strickyak/copico-bonobo/v3.0/capy-3g/RP2350-PICO2-XXL-pinout.jpg

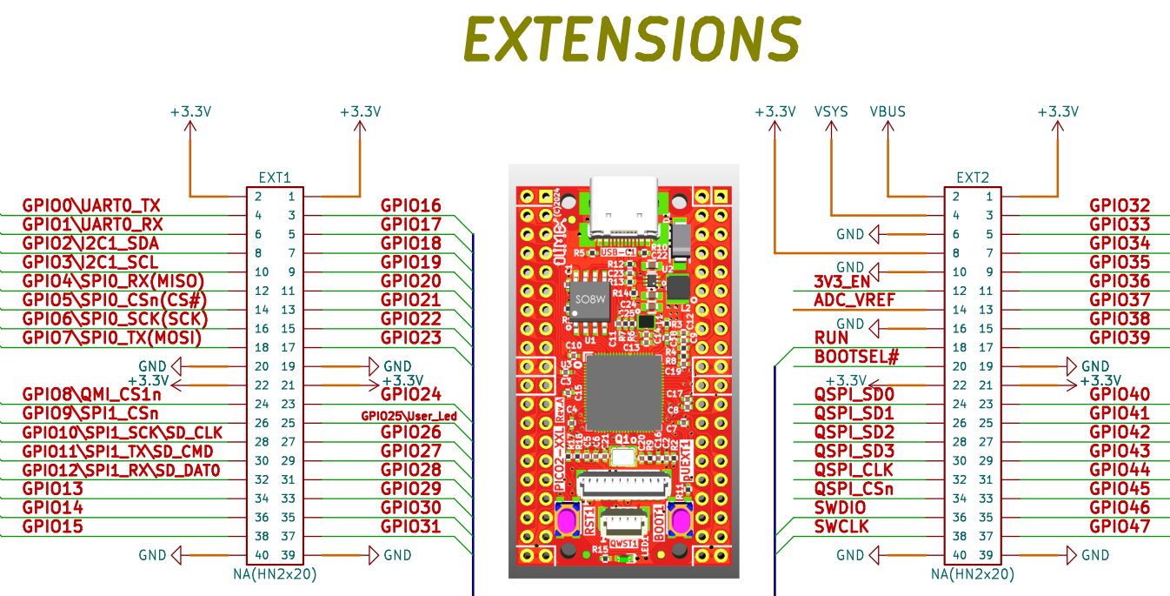
v3.0/capy-3g/RP2350-PICO2-XXL-pinout.jpg
