strickyak/copico-bonobo/README.md

# copico-bonobo
KICAD: Simple and cheap PI PICO cartridge for Coco; can spoonfeed to boot, and has Control &amp; Data ports decoded.
