strickyak/copico-bonobo/v3.1-centipede/centipede-32d/pcb-all.png

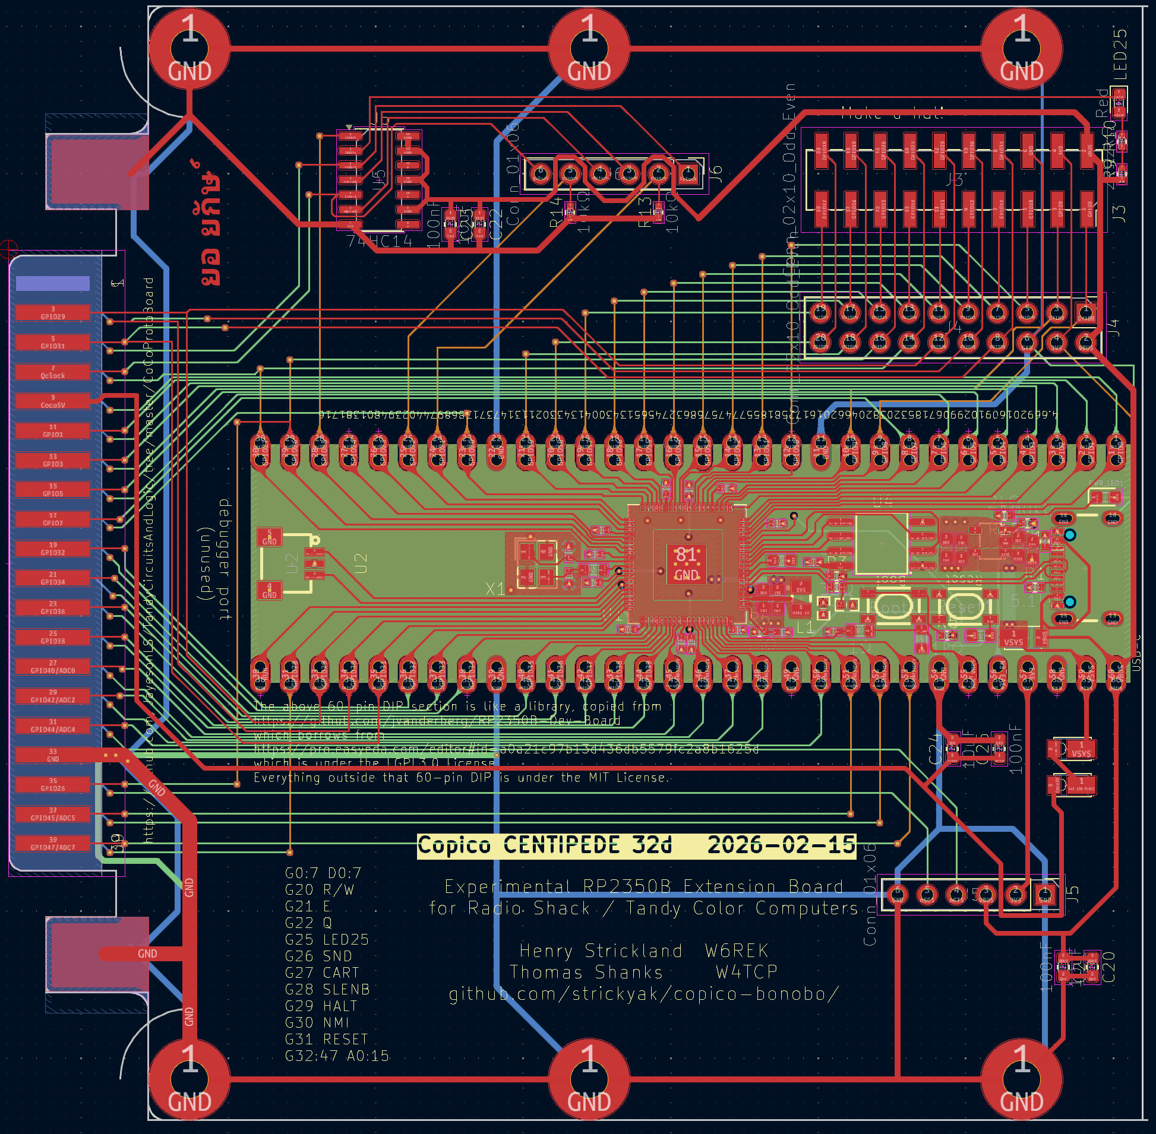
v3.1-centipede/centipede-32d/pcb-all.png
