strickyak/copico-bonobo/v3.1-centipede/centipede-32d/pcb-j3-j4.png

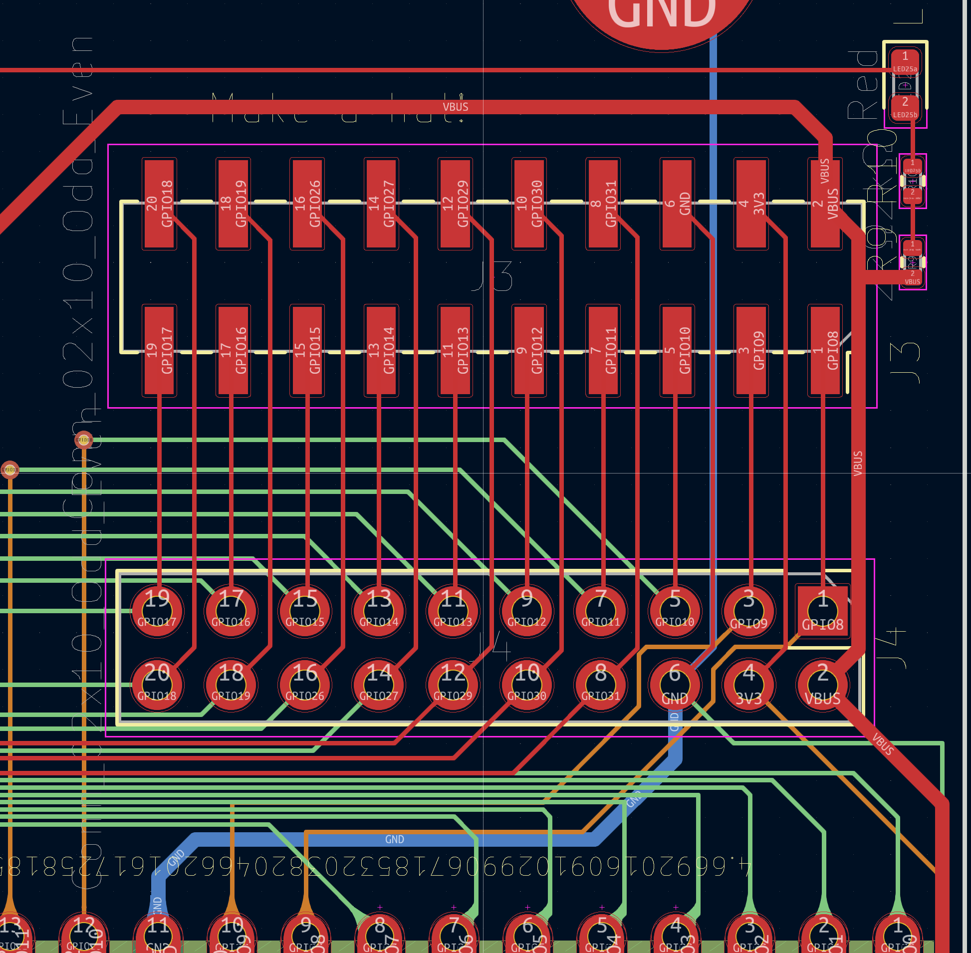
v3.1-centipede/centipede-32d/pcb-j3-j4.png
