strickyak/copico-bonobo/v3.1-centipede/centipede-32d/pcb-j6.png

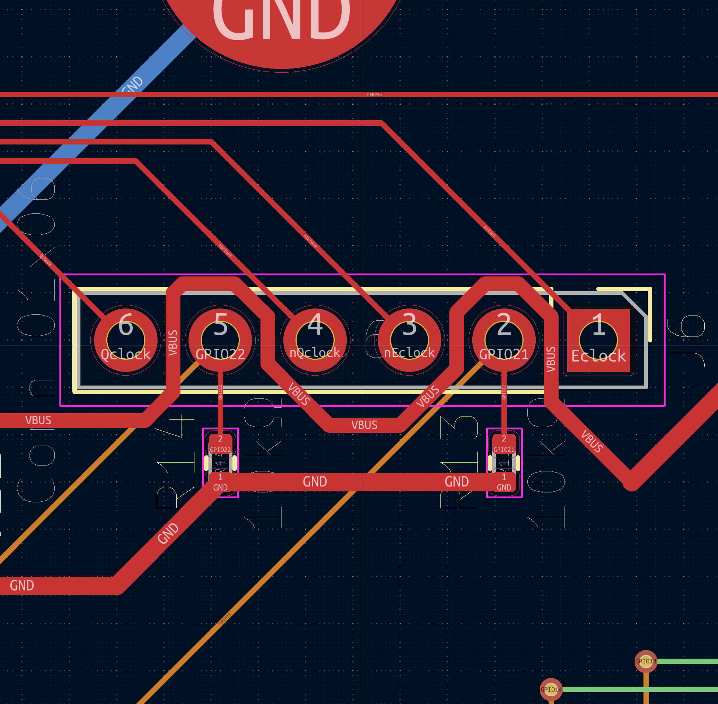
v3.1-centipede/centipede-32d/pcb-j6.png
