strickyak/copico-bonobo/v3.1-centipede/centipede-32d/pcb-rp2350b.png

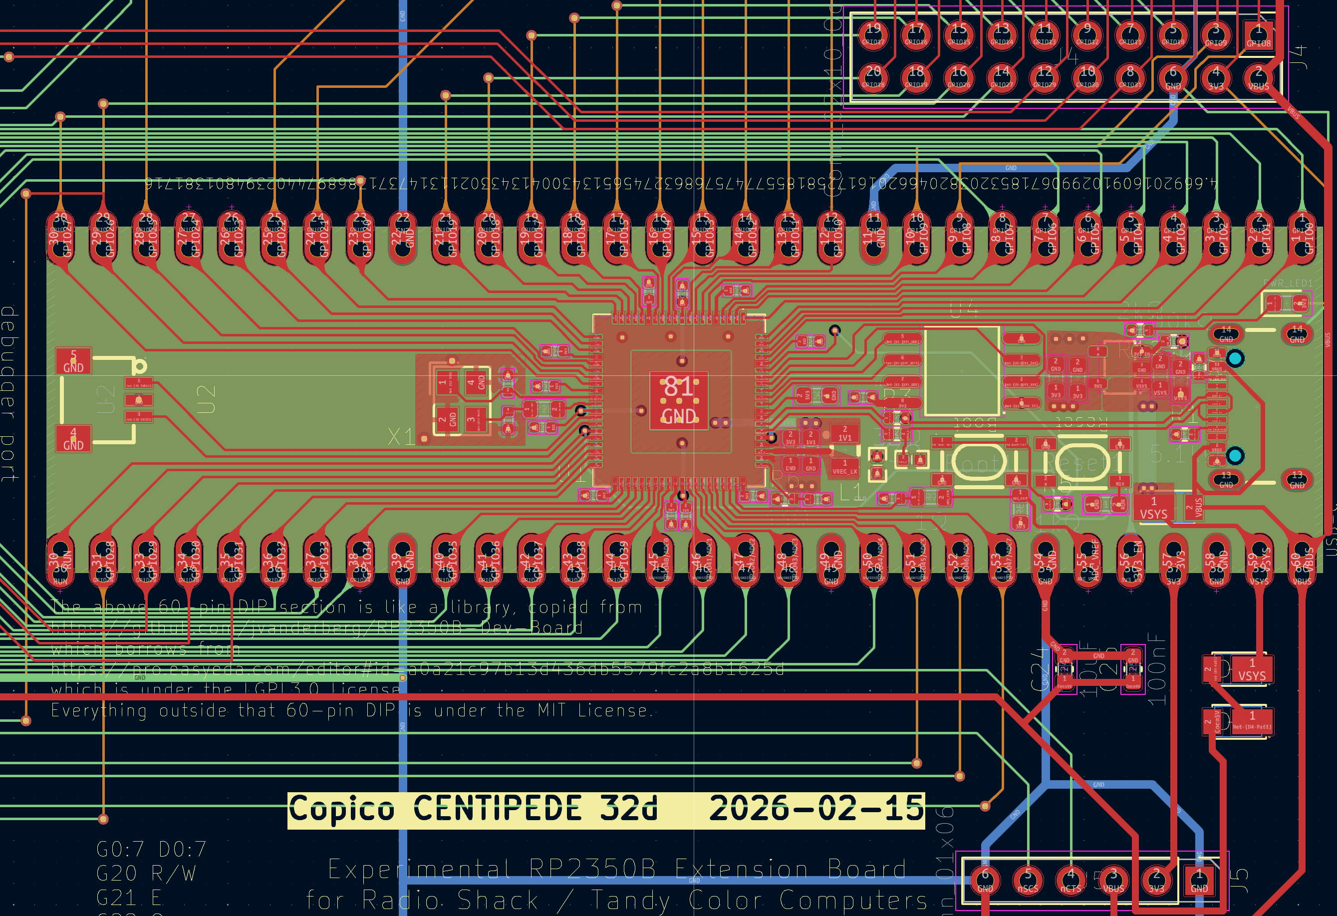
v3.1-centipede/centipede-32d/pcb-rp2350b.png
