strickyak/copico-bonobo/v3.1-centipede/centipede-32d/schematic-additions.png

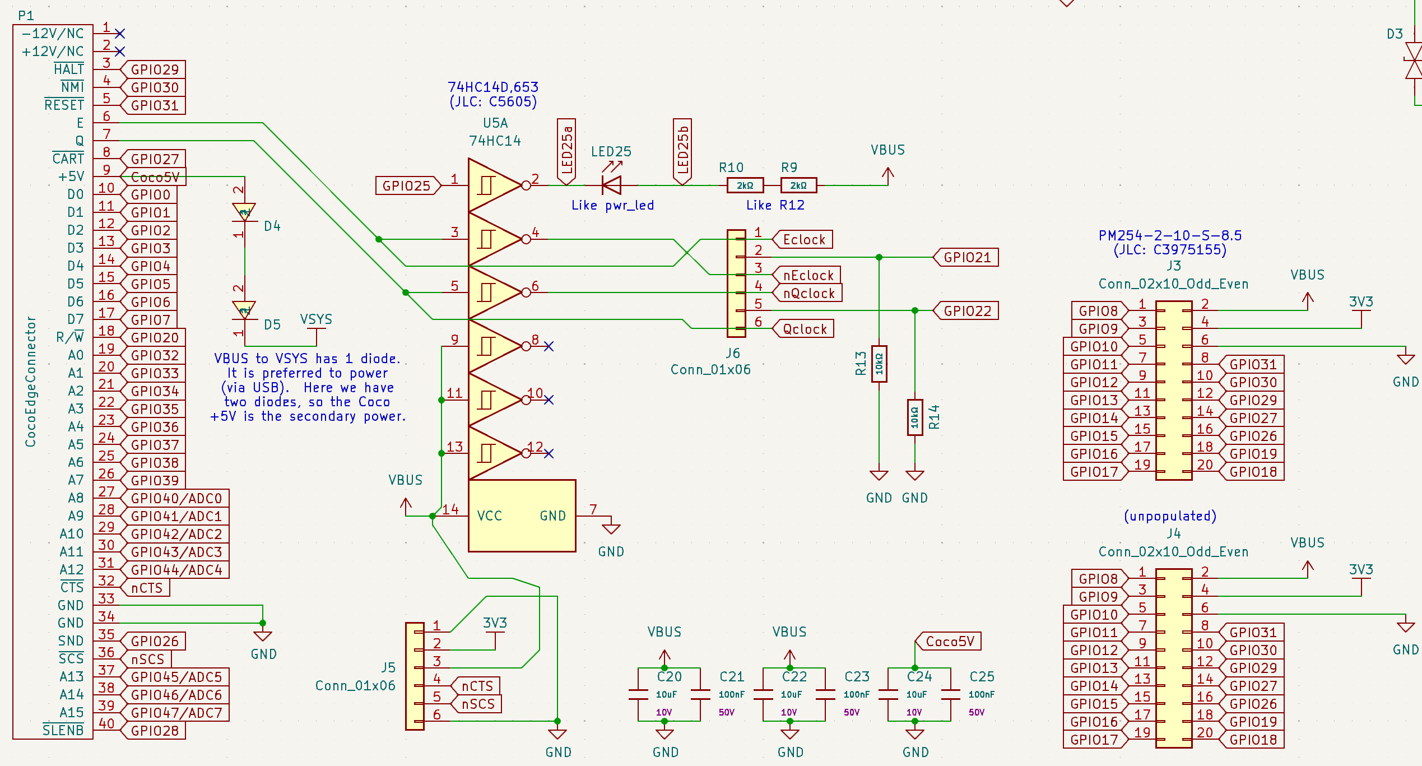
v3.1-centipede/centipede-32d/schematic-additions.png
