strickyak/copico-bonobo/v3.1-centipede/centipede-32d/schematic.png

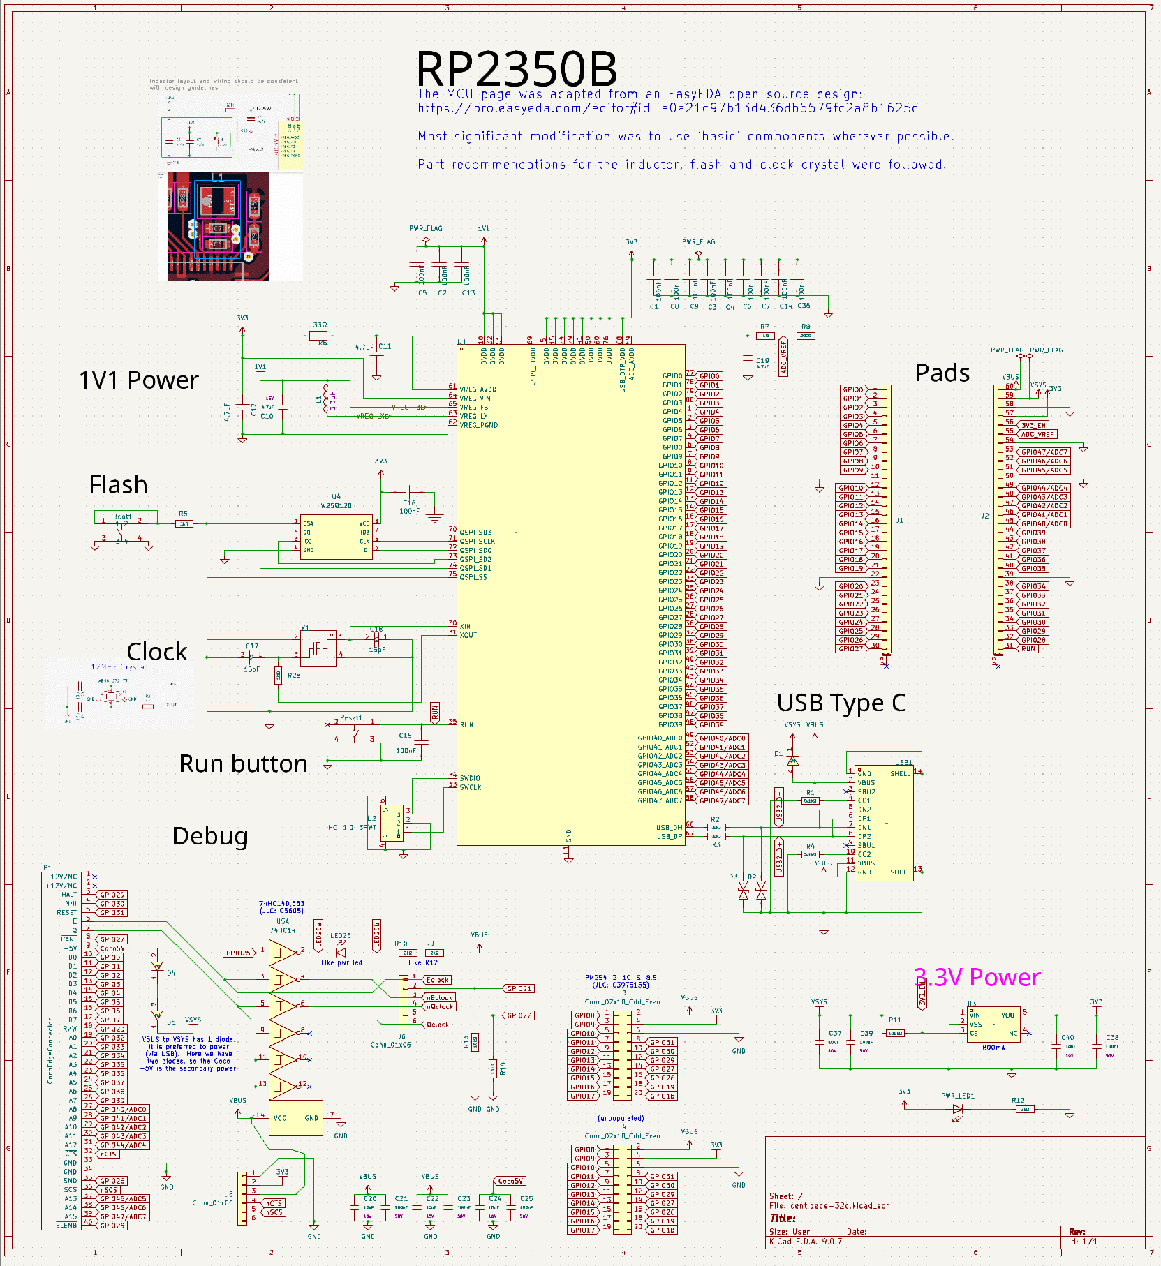
v3.1-centipede/centipede-32d/schematic.png
