strickyak/copico-bonobo/v2.4/spoon24b/bonobo_ricku_topH.stl

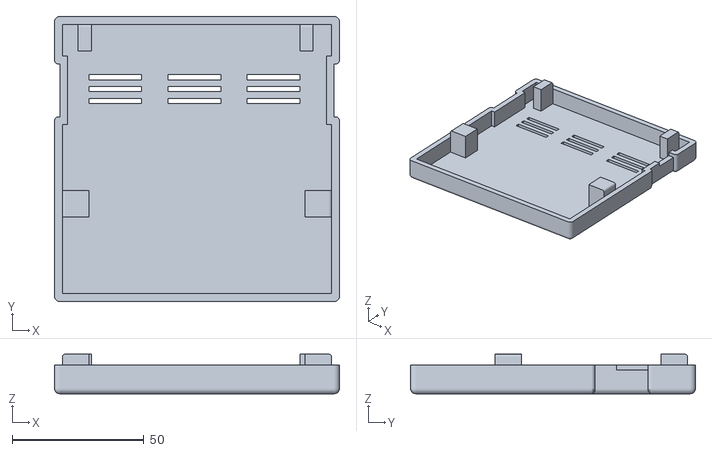
[picture p10: CAD file, 2025-08-13, an earlier design]
v2.4/spoon24b/bonobo_ricku_topH.stl
108.0 x 108.0 x 15.0
