strickyak/copico-bonobo/v3.1-centipede/centipede-32z/centipede-32z.kicad_pcb

## KiCad design v3.1-centipede/centipede-32z/centipede-32z.kicad_pcb (2026-04-16)

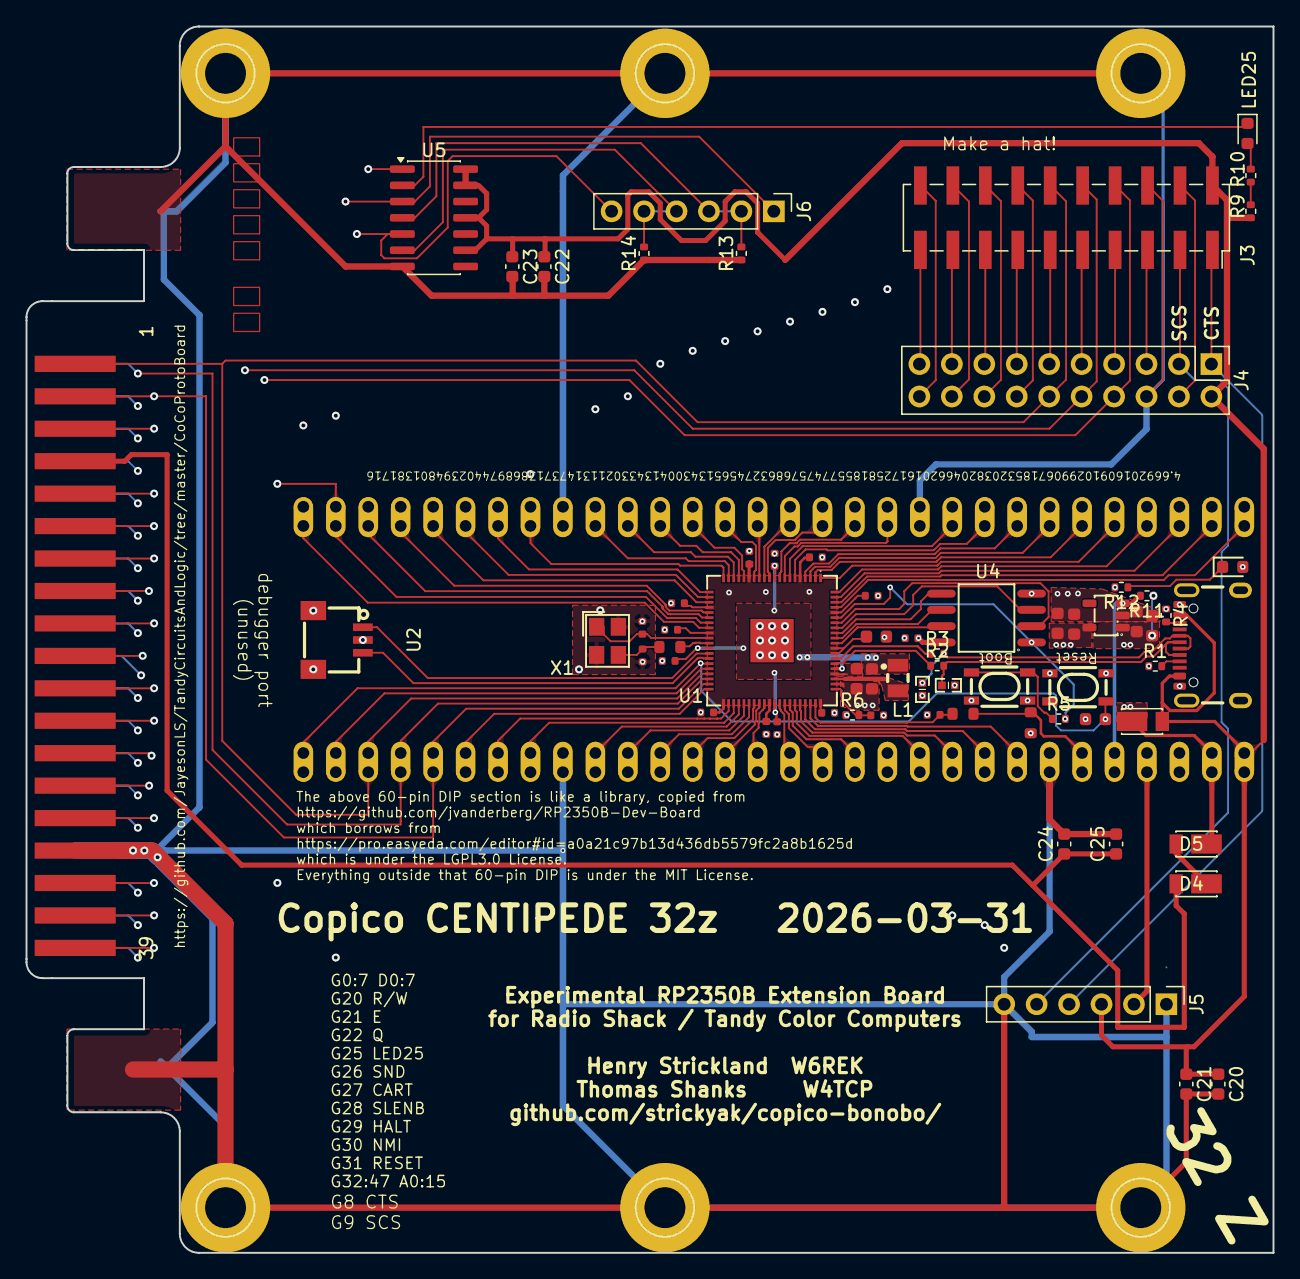
[picture p11: board centipede-32z.kicad_pcb from above]

Board: 4 copper layers, 97.6 x 96.0 mm, 127 parts (0 on the bottom side), 85 nets.

Parts:
3V3_EN1, 3V31: Castellated Pad
ADC_VREF1: Castellated Pad
Boot1: K2-1808SN-A4SW-01; KEY-SMD_4P-L4.2-W3.2-P2.20-LS5.1-TL
C1, C2, C3, C4, C5, C6, C7, C8, C13, C14, C16, C36: 100nF; C_0402
C9, C15, C38, C39: 100nF; C_0603
C10, C12: 4.7uF; C_0603
C11, C19: 4.7uF; C_0402
C17, C18: 15pF; C_0402
C20, C22, C24: 10uF; C_0603_1608Metric
C21, C23, C25: 100nF; C_0603_1608Metric
C37, C40: 10uF; C_0603
D1, D4, D5: POWERDI-123_L2.8-W1.8-LS3.7-RD
D2, D3: RCLAMP0521P.TCT-MS; D0402-BI
GND1, GND2, GND3, GND4, GND4#2, GND6: Castellated Pad
GPI10: Castellated Pad
GPIO0, GPIO1, GPIO1#2, GPIO1#3, GPIO1#4, GPIO1#5, GPIO1#6, GPIO1#7, GPIO1#8, GPIO2, GPIO3, GPIO4, GPIO5, GPIO7, GPIO8, GPIO11, GPIO12, GPIO13, GPIO15, GPIO16, GPIO17, GPIO18, GPIO19, GPIO21, GPIO21#2, GPIO22, GPIO24, GPIO25, GPIO26, GPIO27, GPIO28, GPIO29, GPIO30, GPIO32, GPIO34, GPIO35, GPIO36, GPIO37, GPIO38, GPIO39, GPIO40, GPIO41, GPIO42, GPIO43, GPIO44, GPIO45, GPIO46: Castellated Pad
J3: Conn_02x10_Odd_Even; PinSocket_2x10_P2.54mm_Vertical_SMD
J4: Conn_02x10_Odd_Even; PinHeader_2x10_P2.54mm_Vertical
J5, J6: Conn_01x06; PinHeader_1x06_P2.54mm_Vertical
L1: IND-SMD_L2.0-W1.6_AOTA-B201610S3R3-101-T
LED25: Red; LED_0603_1608Metric
P1: CocoEdgeConnector; CocoCardEdgeCocoMIDI
PWR_LED1: Red; D_0603
R1, R4: 5.1kΩ; R_0402_1005Metric
R2, R3, R6: 33Ω; R_0402_1005Metric
R5: 1kΩ; R_0402_1005Metric
R7: 1Ω; R_0603
R8: 200Ω; R_0603
R9, R10, R12: 2kΩ; R_0402_1005Metric
R11: 100kΩ; R_0402_1005Metric
R13, R14: 10kΩ; R_0402_1005Metric
R28: 1kΩ; R_0603
RUN1: Castellated Pad
Reset1: K2-1808SN-A4SW-01; KEY-SMD_4P-L4.2-W3.2-P2.20-LS5.1-TL
U1: QFN-80_L10.0-W10.0-P0.40-TL-EP3.4
U2: HC-1.0-3PWT; CONN-SMD_SM03B-SRSS-TB-LF-SN-P
U3: SOT-23-5_L3.0-W1.7-P0.95-LS2.8-BR
U4: W25Q128; SOIC-8_L5.3-W5.3-P1.27-LS8.0-BL
U5: 74HC14; SOIC-14_3.9x8.7mm_P1.27mm
USB1: USB-C-SMD_TYPE-C-6PIN-2MD-073
VBUS1: Castellated Pad
VSYS1: Castellated Pad
X1: CRYSTAL-SMD_4P-L3.2-W2.5-BL

Connections:
1V1: C2.1, C5.1, C10.2, C13.2, L1.2, U1.10 (DVDD), U1.32 (DVDD), U1.51 (DVDD), U1.65 (VREG_FB)
3V3: 3V31.57, C1.1, C3.1, C4.1, C6.1, C7.1, C8.2, C9.2, C12.2, C14.2, C16.2, C36.2, C38.1, C40.1, J3.4, J4.4, J5.2, PWR_LED1.2, R6.1, R8.2, U1.5 (IOVDD), U1.15 (IOVDD), U1.24 (IOVDD), U1.29 (IOVDD), U1.41 (IOVDD), U1.50 (IOVDD), U1.60 (IOVDD), U1.64 (VREG_VIN), U1.68 (USB_OTP_VDD), U1.69 (QSPI_IOVDD), U1.76 (IOVDD), U3.5 (VOUT), U4.8 (VCC)
3V3_EN: 3V3_EN1.56, R11.2, U3.3 (CE)
/VREG_LX: L1.1, U1.63 (VREG_LX)
ADC_VREF: ADC_VREF1.55, R7.2, R8.1
Coco5V: C24.1, C25.1, D4.2, P1.9 (+5V)
Eclock: J6.1, P1.6 (E), U5.3
GND: Boot1.3, Boot1.4, C1.2, C2.2, C3.2, C4.2, C5.2, C6.2, C7.2, C8.1, C9.1, C10.1, C11.1, C12.1, C13.1, C14.1, C15.1, C16.1, C17.2, C18.1, C19.2, C20.2, C21.2, C22.2, C23.2, C24.2, C25.2, C36.1, C37.2, C38.2, C39.2, C40.2, D2.1, D3.1, GND2.22, GND3.39, GND4.49, GND4#2.54, GND6.58, GPI10.11, J3.6, J4.6, J5.1, J5.6, P1.33 (GND), P1.34 (GND), R1.1, R4.1, R12.2, R13.1, R14.1, Reset1.3, Reset1.4, U1.62 (VREG_PGND), U1.81 (GND), U2.2, U2.4, U2.5, U3.2 (VSS), U4.4 (GND), U5.7 (GND), USB1.1 (GND), USB1.12 (GND), USB1.13 (SHELL), USB1.14 (SHELL), X1.2 (GND), X1.4 (GND)
GPIO0: GPIO0.1, P1.10 (D0), U1.77 (GPIO0)
GPIO1: GPIO1#2.2, P1.11 (D1), U1.78 (GPIO1)
GPIO2: GPIO2.3, P1.12 (D2), U1.79 (GPIO2)
GPIO3: GPIO3.4, P1.13 (D3), U1.80 (GPIO3)
GPIO4: GPIO4.5, P1.14 (D4), U1.1 (GPIO4)
GPIO5: GPIO5.6, P1.15 (D5), U1.2 (GPIO5)
GPIO6: GPIO1#8.7, P1.16 (D6), U1.3 (GPIO6)
GPIO7: GPIO7.8, P1.17 (D7), U1.4 (GPIO7)
GPIO8: GPIO8.9, J3.1, J4.1, J5.4, P1.32 (~CTS), U1.6 (GPIO8)
GPIO9: GPIO1#7.10, J3.3, J4.3, J5.5, P1.36 (~SCS), U1.7 (GPIO9)
GPIO10: GND1.12, J3.5, J4.5, U1.8 (GPIO10)
GPIO11: GPIO11.13, J3.7, J4.7, U1.9 (GPIO11)
GPIO12: GPIO12.14, J3.9, J4.9, U1.11 (GPIO12)
GPIO13: GPIO13.15, J3.11, J4.11, U1.12 (GPIO13)
GPIO14: GPIO1#6.16, J3.13, J4.13, U1.13 (GPIO14)
GPIO15: GPIO15.17, J3.15, J4.15, U1.14 (GPIO15)
GPIO16: GPIO16.18, J3.17, J4.17, U1.16 (GPIO16)
GPIO17: GPIO17.19, J3.19, J4.19, U1.17 (GPIO17)
GPIO18: GPIO18.20, J3.20, J4.20, U1.18 (GPIO18)
GPIO19: GPIO19.21, J3.18, J4.18, U1.19 (GPIO19)
GPIO20: GPIO21.23, P1.18 (R/~W), U1.20 (GPIO20)
GPIO21: GPIO21#2.24, J6.2, J6.3, R13.2, U1.21 (GPIO21), U5.4
GPIO22: GPIO22.25, J6.4, J6.5, R14.2, U1.22 (GPIO22), U5.6
GPIO23: GPIO1#5.26, U1.23 (GPIO23)
GPIO24: GPIO24.27, U1.25 (GPIO24)
GPIO25: GPIO25.28, U1.26 (GPIO25), U5.1
GPIO26: GPIO26.29, J3.16, J4.16, P1.35 (SND), U1.27 (GPIO26)
GPIO27: GPIO27.30, J3.14, J4.14, P1.8 (~CART), U1.28 (GPIO27)
GPIO28: GPIO28.31, P1.40 (~SLENB), U1.36 (GPIO28)
GPIO29: GPIO29.33, J3.12, J4.12, P1.3 (~HALT), U1.37 (GPIO29)
GPIO30: GPIO30.34, J3.10, J4.10, P1.4 (~NMI), U1.38 (GPIO30)
GPIO31: GPIO1#4.1, GPIO1#4.35, J3.8, J4.8, P1.5 (~RESET), U1.39 (GPIO31)
GPIO32: GPIO1.36, P1.19 (A0), U1.40 (GPIO32)
GPIO33: GPIO32.37, P1.20 (A1), U1.42 (GPIO33)
GPIO34: GPIO34.38, P1.21 (A2), U1.43 (GPIO34)
GPIO35: GPIO35.40, P1.22 (A3), U1.44 (GPIO35)
GPIO36: GPIO36.41, P1.23 (A4), U1.45 (GPIO36)
GPIO37: GPIO37.42, P1.24 (A5), U1.46 (GPIO37)
GPIO38: GPIO38.43, P1.25 (A6), U1.47 (GPIO38)
GPIO39: GPIO39.44, P1.26 (A7), U1.48 (GPIO39)
GPIO40/ADC0: GPIO40.45, P1.27 (A8), U1.49 (GPIO40_ADC0)
GPIO41/ADC1: GPIO41.46, P1.28 (A9), U1.52 (GPIO41_ADC1)
GPIO42/ADC2: GPIO42.47, P1.29 (A10), U1.53 (GPIO42_ADC2)
GPIO43/ADC3: GPIO43.48, P1.30 (A11), U1.54 (GPIO43_ADC3)
GPIO44/ADC4: GPIO44.50, P1.31 (A12), U1.55 (GPIO44_ADC4)
GPIO45/ADC5: GPIO45.51, P1.37 (A13), U1.56 (GPIO45_ADC5)
GPIO46/ADC6: GPIO46.52, P1.38 (A14), U1.57 (GPIO46_ADC6)
GPIO47/ADC7: GPIO1#3.53, P1.39 (A15), U1.58 (GPIO47_ADC7)
LED25a: LED25.1, U5.2
LED25b: LED25.2, R10.1
unnamed: Boot1.1, Boot1.2, R5.1
unnamed: C17.1, R28.1, X1.3
unnamed: D4.1, D5.2
unnamed: PWR_LED1.1, R12.1
unnamed: R9.1, R10.2
unnamed: C19.1, R7.1, U1.59 (ADC_AVDD)
unnamed: U1.71 (QSPI_SCLK), U4.6 (CLK)
unnamed: U1.72 (QSPI_SD0), U4.5 (DI)
unnamed: U1.74 (QSPI_SD1), U4.2 (DO)
unnamed: U1.73 (QSPI_SD2), U4.3 (IO2)
unnamed: U1.70 (QSPI_SD3), U4.7 (IO3)
unnamed: R5.2, U1.75 (QSPI_SS), U4.1 (CS#)
unnamed: U1.33 (SWCLK), U2.1
unnamed: U1.34 (SWDIO), U2.3
unnamed: R2.1, U1.66 (USB_DM)
unnamed: R3.1, U1.67 (USB_DP)
unnamed: C11.2, R6.2, U1.61 (VREG_AVDD)
unnamed: C18.2, U1.30 (XIN), X1.1
unnamed: R28.2, U1.31 (XOUT)
unnamed: R1.2, USB1.4 (CC1)
unnamed: R4.2, USB1.10 (CC2)
Qclock: J6.6, P1.7 (Q), U5.5
RUN: C15.2, RUN1.30, Reset1.1, U1.35 (RUN)
USB2_D+: D3.2, R3.2, USB1.6 (DP1), USB1.8 (DP2)
USB2_D-: D2.2, R2.2, USB1.5 (DN2), USB1.7 (DN1)
VBUS: C20.1, C21.1, C22.1, C23.1, D1.2, J3.2, J4.2, J5.3, R9.2, U5.9, U5.11, U5.13, U5.14 (VCC), USB1.2 (VBUS), USB1.11 (VBUS), VBUS1.60
VSYS: C37.1, C39.1, D1.1, D5.1, R11.1, U3.1 (VIN), VSYS1.59
