strickyak/copico-bonobo/v3.0/capy-3g/capy-3g.kicad_pcb

## KiCad design v3.0/capy-3g/capy-3g.kicad_pcb (2025-05-19)

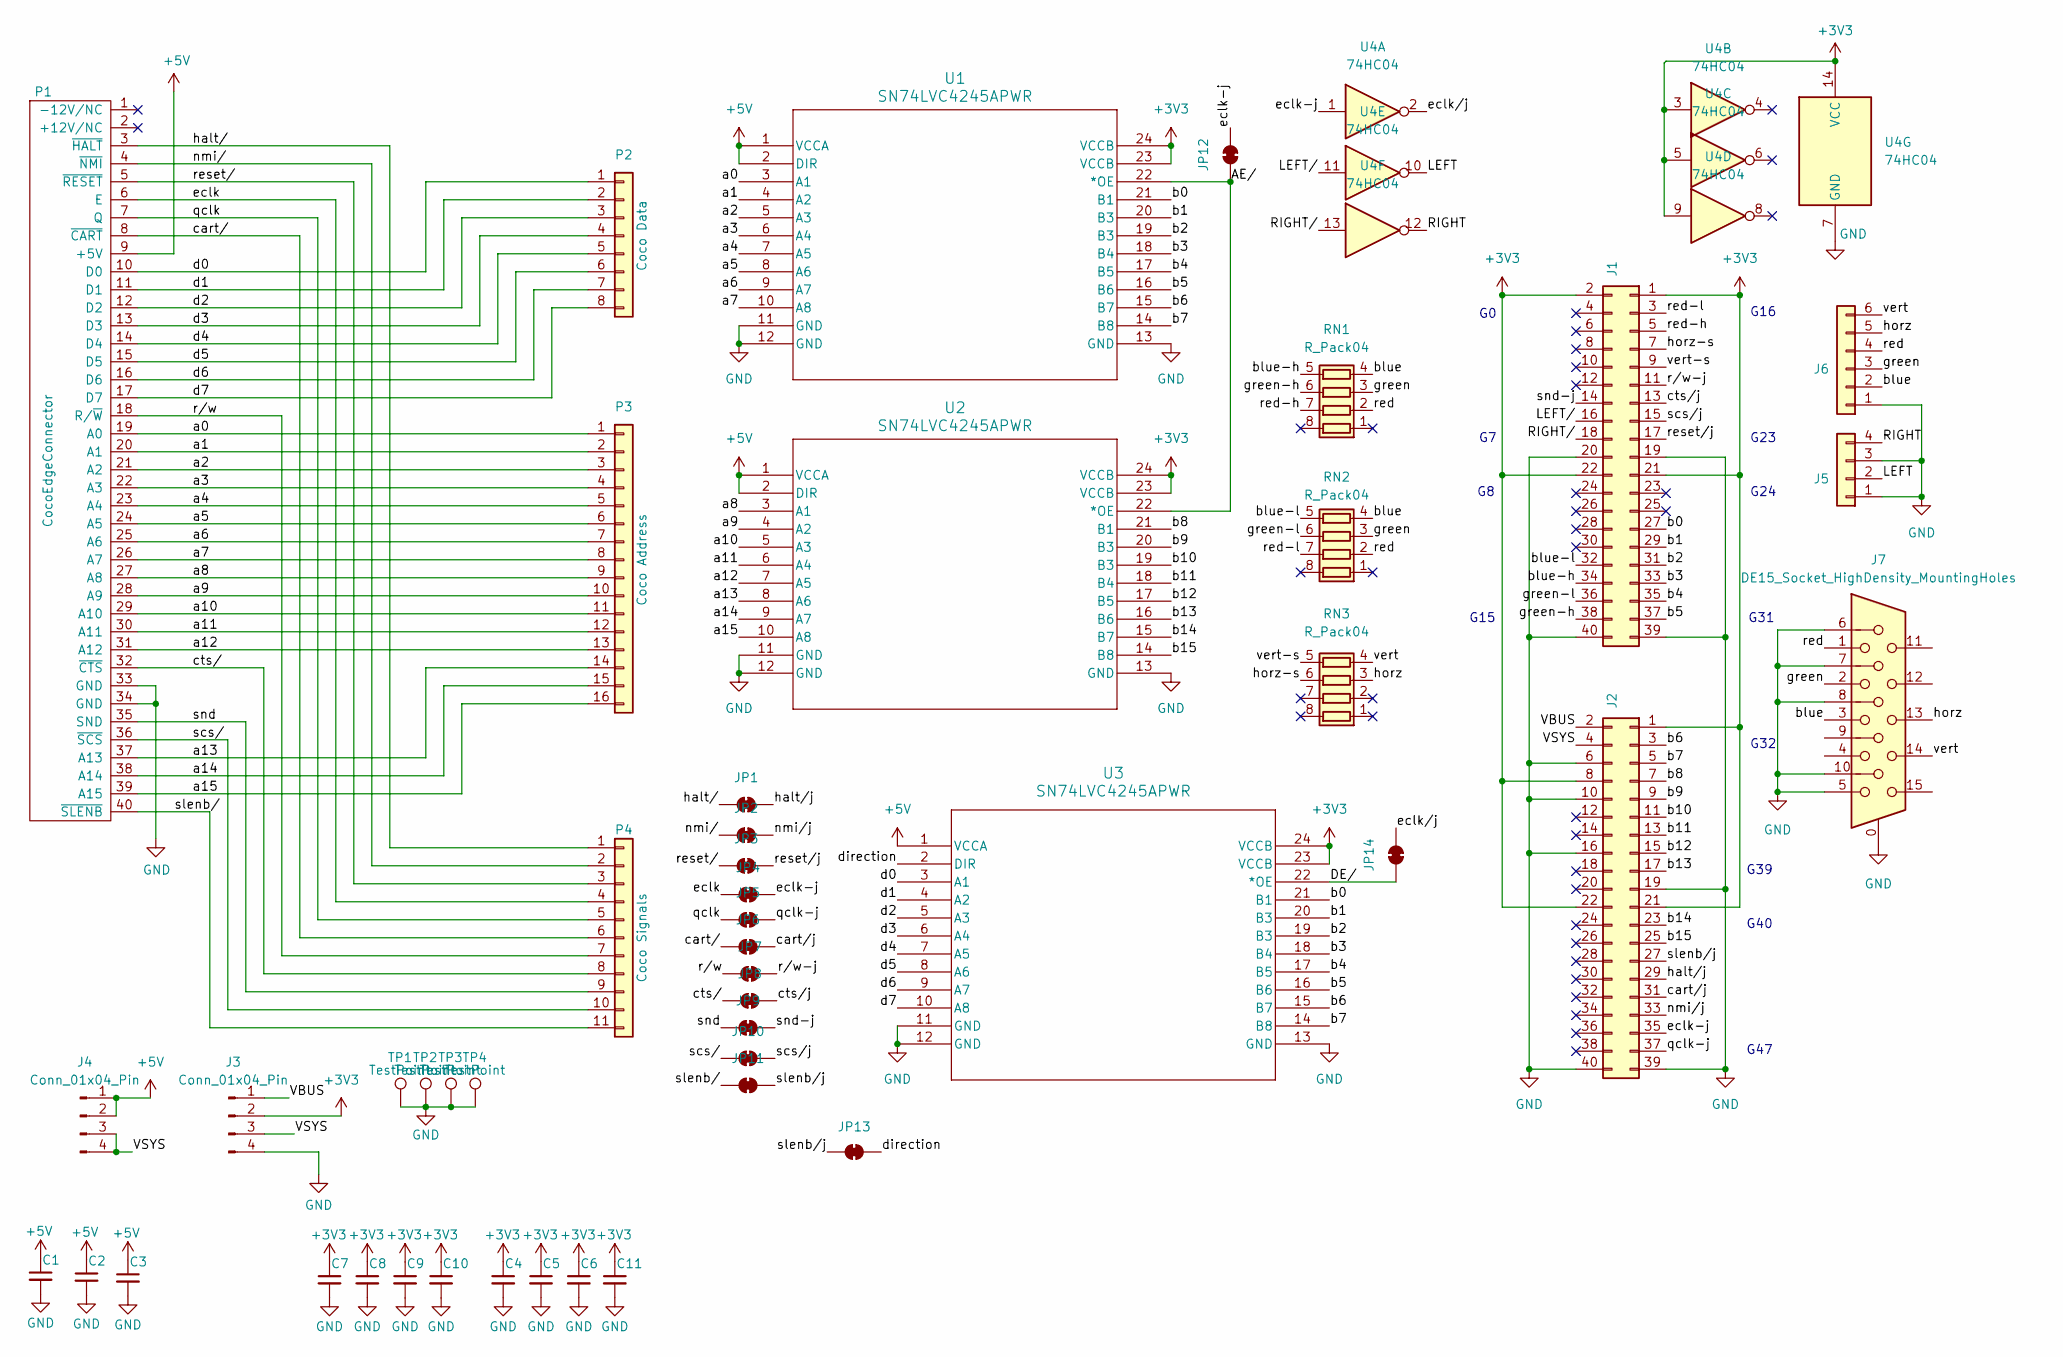
[picture p12: schematic capy-3g.kicad_sch, COPICO Bonobo]

Parts:
C1, C2, C3, C4, C5, C6, C7, C8, C9, C10, C11: C_Small; C_0402_1005Metric
J1, J2: Conn_02x20_Odd_Even; PinHeader_2x20_P2.54mm_Vertical
J3, J4: Conn_01x04_Pin; PinHeader_1x04_P2.54mm_Vertical
J5: Conn_01x04; PinHeader_1x04_P2.54mm_Vertical
J6: Conn_01x06; PinHeader_1x06_P2.54mm_Vertical
J7: DE15_Socket_HighDensity_MountingHoles; DSUB-15-HD_Socket_Vertical_P2.29x1.98mm_MountingHoles
JP1, JP2, JP3, JP4, JP5, JP6, JP7, JP8, JP9, JP10, JP11, JP12, JP13, JP14: SolderJumper_2_Bridged; SolderJumper-2_P1.3mm_Bridged_RoundedPad1.0x1.5mm
P1: CocoEdgeConnector; CocoCardEdgeCocoMIDI
P2: Coco Data; DIP-16_W7.62mm
P3: Coco Address; DIP-32_W15.24mm
P4: Coco Signals; DIP-22_W10.16mm
RN1, RN2, RN3: R_Pack04; R_Array_Convex_4x0603
TP1, TP2, TP3, TP4: TestPoint; TestPoint_Plated_Hole_D4.0mm
U1, U2, U3: SN74LVC4245APWR; TSSOP-24_4.4x7.8mm_P0.65mm
U4: 74HC04; TSSOP-14_4.4x5mm_P0.65mm

Connections:
+3V3: C4.1, C5.1, C6.1, C7.1, C8.1, C9.1, C10.1, C11.1, J1.1, J1.2, J1.21, J1.22, J2.1, J2.8, J2.21, J2.22, J3.2, U1.23 (VCCB), U1.24 (VCCB), U2.23 (VCCB), U2.24 (VCCB), U3.23 (VCCB), U3.24 (VCCB), U4.3, U4.5, U4.9, U4.14 (VCC)
+5V: C1.1, C2.1, C3.1, J4.1, J4.2, P1.9 (+5V), U1.1 (VCCA), U1.2 (DIR), U2.1 (VCCA), U2.2 (DIR), U3.1 (VCCA)
/AE/: JP12.1 (A), U1.22 (*OE), U2.22 (*OE)
/DE/: JP14.1 (A), U3.22 (*OE)
/LEFT: J5.2, U4.10
/LEFT/: J1.16, U4.11
/RIGHT: J5.4, U4.12
/RIGHT/: J1.18, U4.13
/VBUS: J2.2, J3.1
/VSYS: J2.4, J3.3, J4.3, J4.4
/a0: P1.19 (A0), P3.1, U1.3 (A1)
/a1: P1.20 (A1), P3.2, U1.4 (A2)
/a2: P1.21 (A2), P3.3, U1.5 (A3)
/a3: P1.22 (A3), P3.4, U1.6 (A4)
/a4: P1.23 (A4), P3.5, U1.7 (A5)
/a5: P1.24 (A5), P3.6, U1.8 (A6)
/a6: P1.25 (A6), P3.7, U1.9 (A7)
/a7: P1.26 (A7), P3.8, U1.10 (A8)
/a8: P1.27 (A8), P3.9, U2.3 (A1)
/a9: P1.28 (A9), P3.10, U2.4 (A2)
/a10: P1.29 (A10), P3.11, U2.5 (A3)
/a11: P1.30 (A11), P3.12, U2.6 (A4)
/a12: P1.31 (A12), P3.13, U2.7 (A5)
/a13: P1.37 (A13), P3.14, U2.8 (A6)
/a14: P1.38 (A14), P3.15, U2.9 (A7)
/a15: P1.39 (A15), P3.16, U2.10 (A8)
/b0: J1.27, U1.21 (B1), U3.21 (B1)
/b1: J1.29, U1.20 (B3), U3.20 (B3)
/b2: J1.31, U1.19 (B3), U3.19 (B3)
/b3: J1.33, U1.18 (B4), U3.18 (B4)
/b4: J1.35, U1.17 (B5), U3.17 (B5)
/b5: J1.37, U1.16 (B6), U3.16 (B6)
/b6: J2.3, U1.15 (B7), U3.15 (B7)
/b7: J2.5, U1.14 (B8), U3.14 (B8)
/b8: J2.7, U2.21 (B1)
/b9: J2.9, U2.20 (B3)
/b10: J2.11, U2.19 (B3)
/b11: J2.13, U2.18 (B4)
/b12: J2.15, U2.17 (B5)
/b13: J2.17, U2.16 (B6)
/b14: J2.23, U2.15 (B7)
/b15: J2.25, U2.14 (B8)
/blue: J6.2, J7.3, RN1.4 (R4.1), RN2.4 (R4.1)
/blue-h: J1.34, RN1.5 (R4.2)
/blue-l: J1.32, RN2.5 (R4.2)
/cart/: JP6.1 (A), P1.8 (~CART), P4.6
/cart/j: J2.31, JP6.2 (B)
/cts/: JP8.1 (A), P1.32 (~CTS), P4.8
/cts/j: J1.13, JP8.2 (B)
/d0: P1.10 (D0), P2.1, U3.3 (A1)
/d1: P1.11 (D1), P2.2, U3.4 (A2)
/d2: P1.12 (D2), P2.3, U3.5 (A3)
/d3: P1.13 (D3), P2.4, U3.6 (A4)
/d4: P1.14 (D4), P2.5, U3.7 (A5)
/d5: P1.15 (D5), P2.6, U3.8 (A6)
/d6: P1.16 (D6), P2.7, U3.9 (A7)
/d7: P1.17 (D7), P2.8, U3.10 (A8)
/direction: JP13.1 (A), U3.2 (DIR)
/eclk: JP4.1 (A), P1.6 (E), P4.4
/eclk-j: J2.35, JP4.2 (B), JP12.2 (B), U4.1
/eclk/j: JP14.2 (B), U4.2
/green: J6.3, J7.2, RN1.3 (R3.1), RN2.3 (R3.1)
/green-h: J1.38, RN1.6 (R3.2)
/green-l: J1.36, RN2.6 (R3.2)
/halt/: JP1.1 (A), P1.3 (~HALT), P4.1
/halt/j: J2.29, JP1.2 (B)
/horz: J6.5, J7.13, RN3.3 (R3.1)
/horz-s: J1.7, RN3.6 (R3.2)
/nmi/: JP2.1 (A), P1.4 (~NMI), P4.2
/nmi/j: J2.33, JP2.2 (B)
/qclk: JP5.1 (A), P1.7 (Q), P4.5
/qclk-j: J2.37, JP5.2 (B)
/red: J6.4, J7.1, RN1.2 (R2.1), RN2.2 (R2.1)
/red-h: J1.5, RN1.7 (R2.2)
/red-l: J1.3, RN2.7 (R2.2)
/reset/: JP3.1 (A), P1.5 (~RESET), P4.3
/reset/j: J1.17, JP3.2 (B)
/r/w: JP7.1 (A), P1.18 (R/~W), P4.7
/r/w-j: J1.11, JP7.2 (B)
/scs/: JP10.1 (A), P1.36 (~SCS), P4.10
/scs/j: J1.15, JP10.2 (B)
/slenb/: JP11.1 (A), P1.40 (~SLENB), P4.11
/slenb/j: J2.27, JP11.2 (B), JP13.2 (B)
/snd: JP9.1 (A), P1.35 (SND), P4.9
/snd-j: J1.14, JP9.2 (B)
/vert: J6.6, J7.14, RN3.4 (R4.1)
/vert-s: J1.9, RN3.5 (R4.2)
GND: C1.2, C2.2, C3.2, C4.2, C5.2, C6.2, C7.2, C8.2, C9.2, C10.2, C11.2, J1.19, J1.20, J1.39, J1.40, J2.6, J2.10, J2.16, J2.19, J2.39, J2.40, J3.4, J5.1, J5.3, J6.1, J7.0, J7.5, J7.6, J7.7, J7.8, J7.10, P1.33 (GND), P1.34 (GND), TP1.1, TP2.1, TP3.1, TP4.1, U1.11 (GND), U1.12 (GND), U1.13 (GND), U2.11 (GND), U2.12 (GND), U2.13 (GND), U3.11 (GND), U3.12 (GND), U3.13 (GND), U4.7 (GND)

Notes on the sheet:
G40
G23
G15
G31
G24
G32
G39
G47
G16

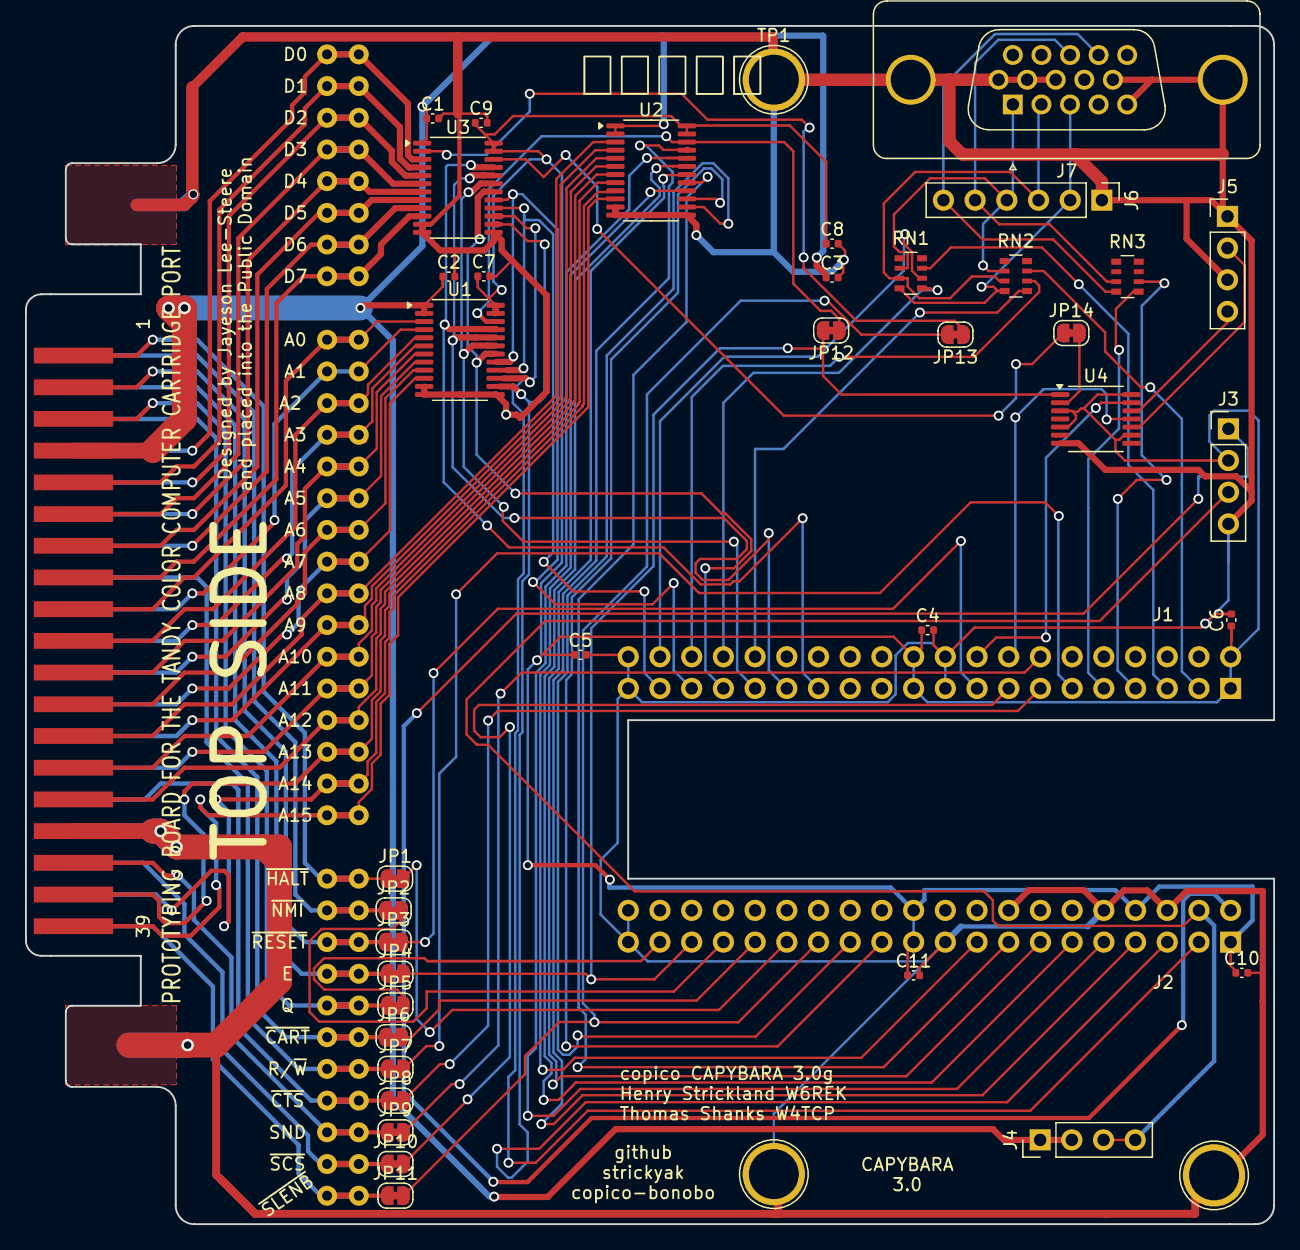
[picture p13: board capy-3g.kicad_pcb from above]

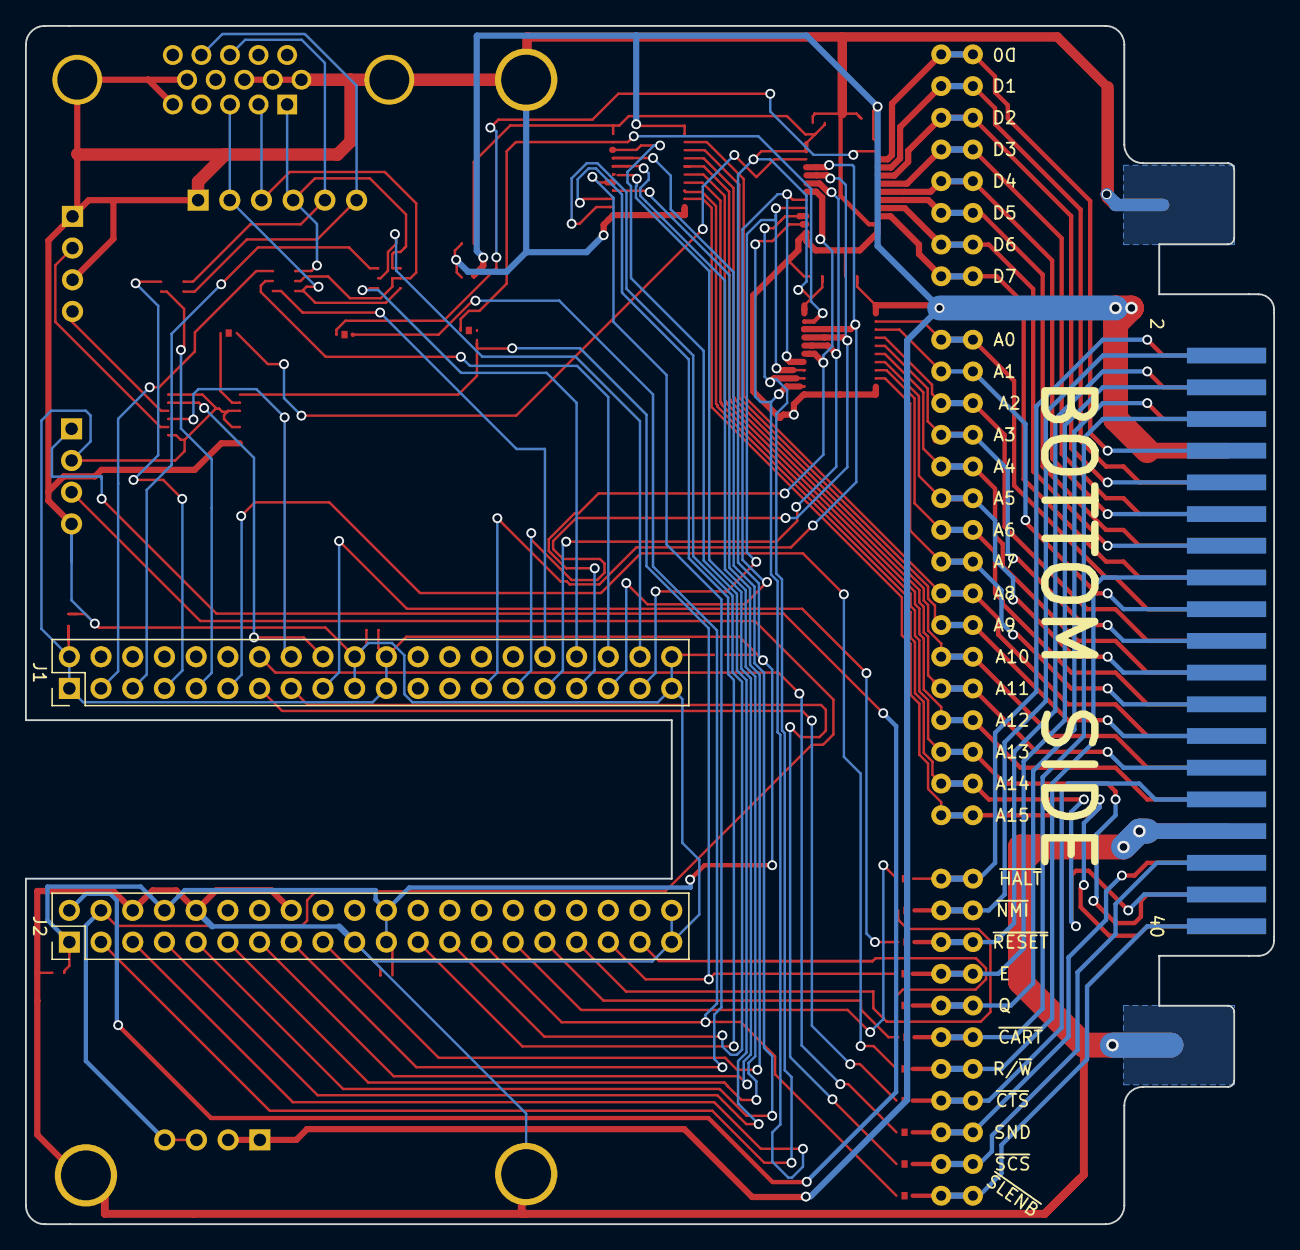
[picture p14: board capy-3g.kicad_pcb from below]

Board: 2 copper layers, 100.0 x 96.0 mm, 46 parts (2 on the bottom side), 88 nets.
