strickyak/copico-bonobo/v2.4/spoon24b/spoon24b.kicad_pcb

## KiCad design v2.4/spoon24b/spoon24b.kicad_pcb (2025-02-24, an earlier design)

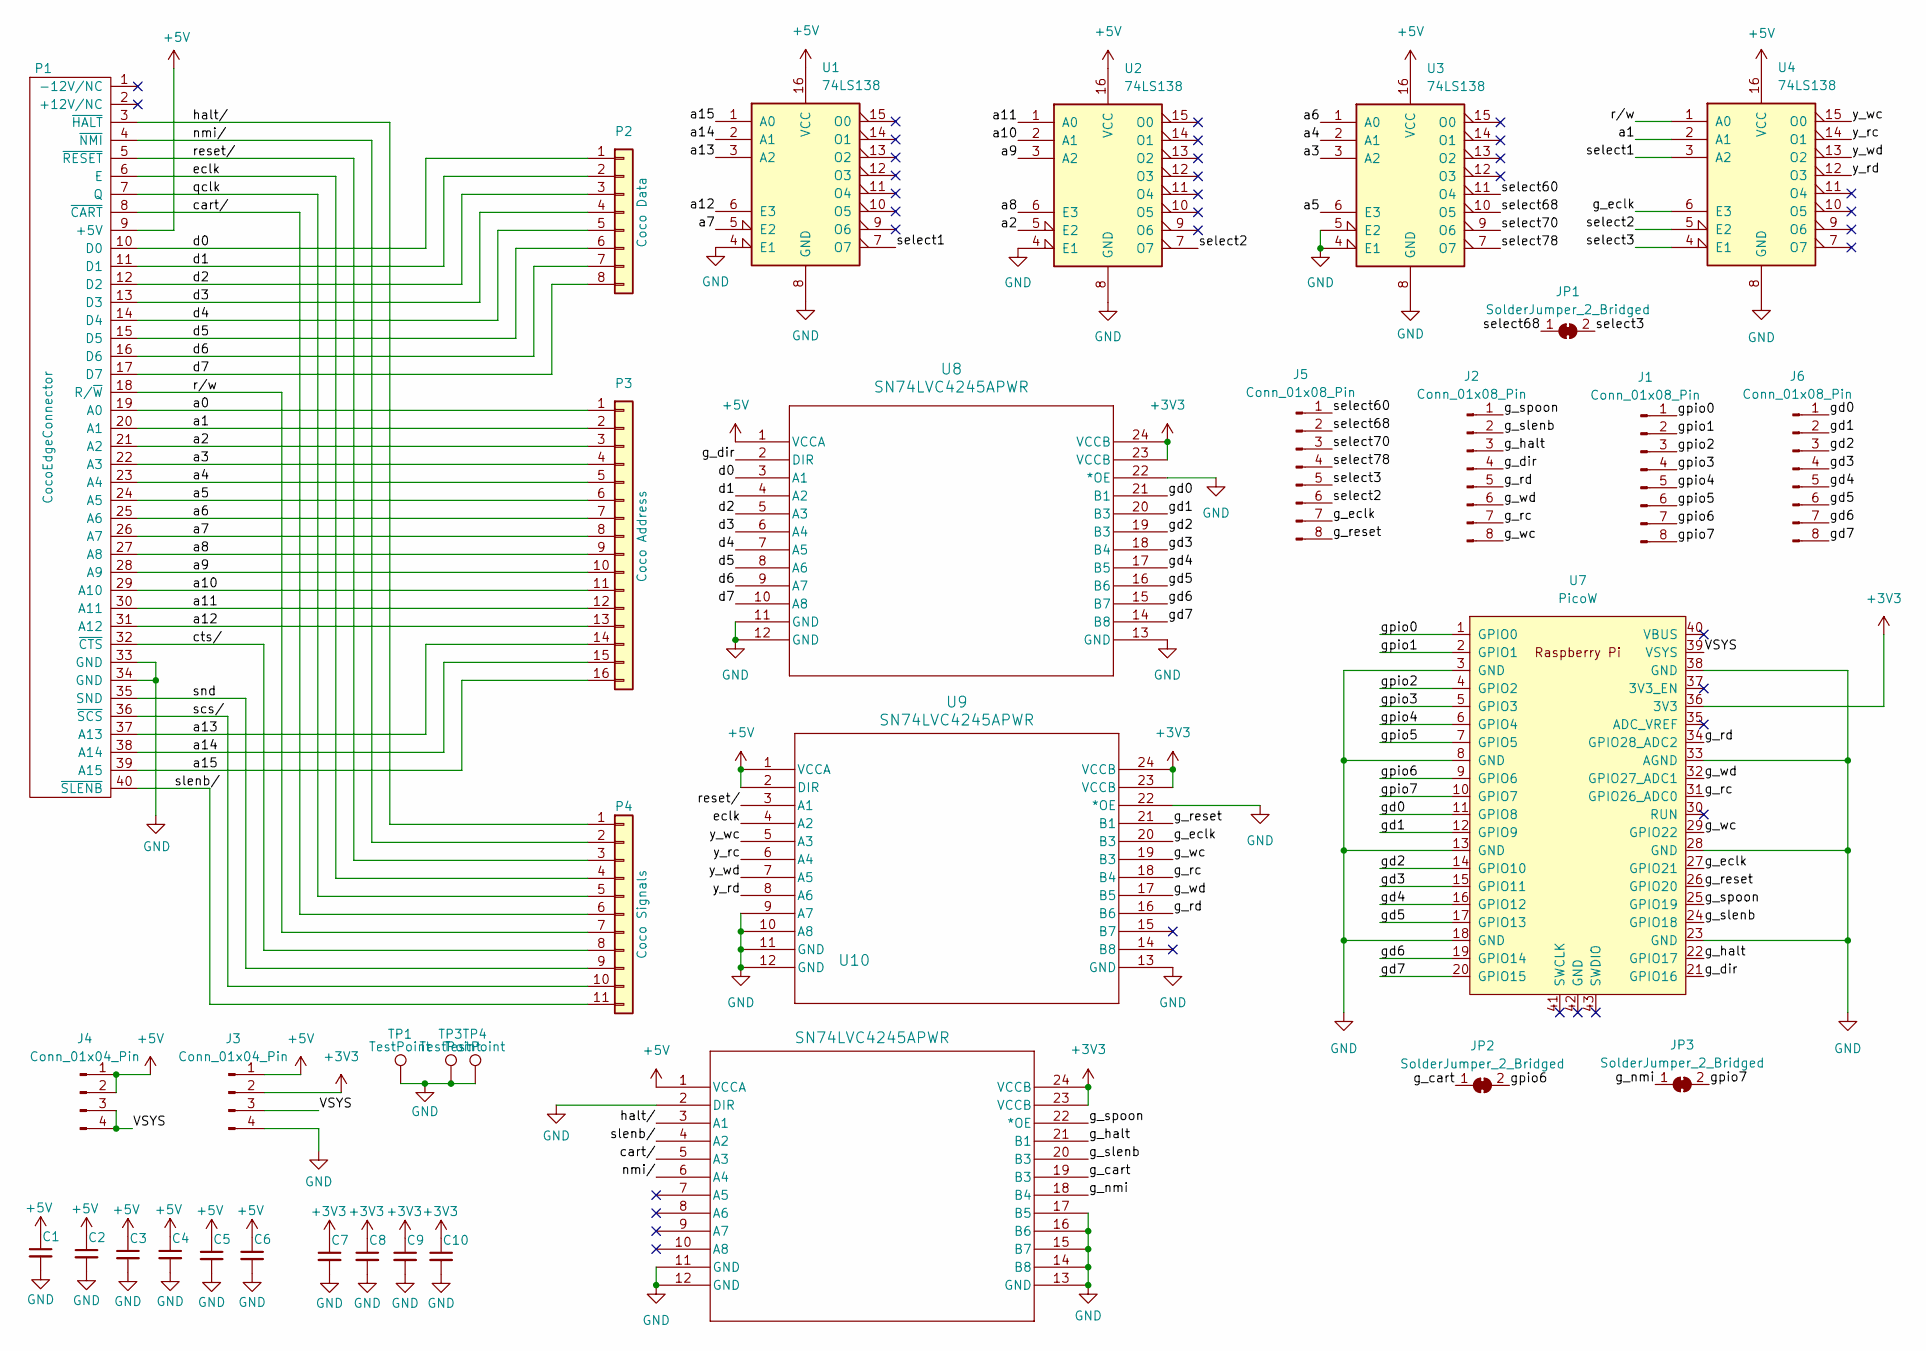
[picture p15: schematic spoon24b.kicad_sch, COPICO Bonobo]

Parts:
C1, C2, C3, C4, C5, C6, C7, C8, C9, C10: C_Small; C_0402_1005Metric
J1, J2, J5, J6: Conn_01x08_Pin; PinHeader_1x08_P2.54mm_Vertical
J3, J4: Conn_01x04_Pin; PinHeader_1x04_P2.54mm_Vertical
JP1, JP2, JP3: SolderJumper_2_Bridged; SolderJumper-2_P1.3mm_Bridged_Pad1.0x1.5mm
P1: CocoEdgeConnector; CocoCardEdgeCocoMIDI
P2: Coco Data; DIP-16_W7.62mm
P3: Coco Address; DIP-32_W15.24mm
P4: Coco Signals; DIP-22_W10.16mm
TP1, TP3, TP4: TestPoint; TestPoint_Plated_Hole_D4.0mm
U1, U2, U3, U4: 74LS138; SOIC-16_3.9x9.9mm_P1.27mm
U7: PicoW; RPi_PicoW_SMD_TH
U8, U9, U10: SN74LVC4245APWR; TSSOP-24_4.4x7.8mm_P0.65mm

Connections:
+3V3: C7.1, C8.1, C9.1, C10.1, J3.2, U7.36 (3V3), U8.23 (VCCB), U8.24 (VCCB), U9.23 (VCCB), U9.24 (VCCB), U10.23 (VCCB), U10.24 (VCCB)
+5V: C1.1, C2.1, C3.1, C4.1, C5.1, C6.1, J3.1, J4.1, J4.2, P1.9 (+5V), U1.16 (VCC), U2.16 (VCC), U3.16 (VCC), U4.16 (VCC), U8.1 (VCCA), U9.1 (VCCA), U9.2 (DIR), U10.1 (VCCA)
/VSYS: J3.3, J4.3, J4.4, U7.39 (VSYS)
/a0: P1.19 (A0), P3.1
/a1: P1.20 (A1), P3.2, U4.2 (A1)
/a2: P1.21 (A2), P3.3, U2.5 (E2)
/a3: P1.22 (A3), P3.4, U3.3 (A2)
/a4: P1.23 (A4), P3.5, U3.2 (A1)
/a5: P1.24 (A5), P3.6, U3.6 (E3)
/a6: P1.25 (A6), P3.7, U3.1 (A0)
/a7: P1.26 (A7), P3.8, U1.5 (E2)
/a8: P1.27 (A8), P3.9, U2.6 (E3)
/a9: P1.28 (A9), P3.10, U2.3 (A2)
/a10: P1.29 (A10), P3.11, U2.2 (A1)
/a11: P1.30 (A11), P3.12, U2.1 (A0)
/a12: P1.31 (A12), P3.13, U1.6 (E3)
/a13: P1.37 (A13), P3.14, U1.3 (A2)
/a14: P1.38 (A14), P3.15, U1.2 (A1)
/a15: P1.39 (A15), P3.16, U1.1 (A0)
/cart/: P1.8 (~CART), P4.6, U10.5 (A3)
/cts/: P1.32 (~CTS), P4.8
/d0: P1.10 (D0), P2.1, U8.3 (A1)
/d1: P1.11 (D1), P2.2, U8.4 (A2)
/d2: P1.12 (D2), P2.3, U8.5 (A3)
/d3: P1.13 (D3), P2.4, U8.6 (A4)
/d4: P1.14 (D4), P2.5, U8.7 (A5)
/d5: P1.15 (D5), P2.6, U8.8 (A6)
/d6: P1.16 (D6), P2.7, U8.9 (A7)
/d7: P1.17 (D7), P2.8, U8.10 (A8)
/eclk: P1.6 (E), P4.4, U9.4 (A2)
/g_cart: JP2.1 (A), U10.19 (B3)
/g_dir: J2.4, U7.21 (GPIO16), U8.2 (DIR)
/g_eclk: J5.7, U4.6 (E3), U7.27 (GPIO21), U9.20 (B3)
/g_halt: J2.3, U7.22 (GPIO17), U10.21 (B1)
/g_nmi: JP3.1 (A), U10.18 (B4)
/g_rc: J2.7, U7.31 (GPIO26_ADC0), U9.18 (B4)
/g_rd: J2.5, U7.34 (GPIO28_ADC2), U9.16 (B6)
/g_reset: J5.8, U7.26 (GPIO20), U9.21 (B1)
/g_slenb: J2.2, U7.24 (GPIO18), U10.20 (B3)
/g_spoon: J2.1, U7.25 (GPIO19), U10.22 (*OE)
/g_wc: J2.8, U7.29 (GPIO22), U9.19 (B3)
/g_wd: J2.6, U7.32 (GPIO27_ADC1), U9.17 (B5)
/gd0: J6.1, U7.11 (GPIO8), U8.21 (B1)
/gd1: J6.2, U7.12 (GPIO9), U8.20 (B3)
/gd2: J6.3, U7.14 (GPIO10), U8.19 (B3)
/gd3: J6.4, U7.15 (GPIO11), U8.18 (B4)
/gd4: J6.5, U7.16 (GPIO12), U8.17 (B5)
/gd5: J6.6, U7.17 (GPIO13), U8.16 (B6)
/gd6: J6.7, U7.19 (GPIO14), U8.15 (B7)
/gd7: J6.8, U7.20 (GPIO15), U8.14 (B8)
/gpio0: J1.1, U7.1 (GPIO0)
/gpio1: J1.2, U7.2 (GPIO1)
/gpio2: J1.3, U7.4 (GPIO2)
/gpio3: J1.4, U7.5 (GPIO3)
/gpio4: J1.5, U7.6 (GPIO4)
/gpio5: J1.6, U7.7 (GPIO5)
/gpio6: J1.7, JP2.2 (B), U7.9 (GPIO6)
/gpio7: J1.8, JP3.2 (B), U7.10 (GPIO7)
/halt/: P1.3 (~HALT), P4.1, U10.3 (A1)
/nmi/: P1.4 (~NMI), P4.2, U10.6 (A4)
/qclk: P1.7 (Q), P4.5
/reset/: P1.5 (~RESET), P4.3, U9.3 (A1)
/r/w: P1.18 (R/~W), P4.7, U4.1 (A0)
/scs/: P1.36 (~SCS), P4.10
/select1: U1.7 (O7), U4.3 (A2)
/select2: J5.6, U2.7 (O7), U4.5 (E2)
/select3: J5.5, JP1.2 (B), U4.4 (E1)
/select60: J5.1, U3.11 (O4)
/select68: J5.2, JP1.1 (A), U3.10 (O5)
/select70: J5.3, U3.9 (O6)
/select78: J5.4, U3.7 (O7)
/slenb/: P1.40 (~SLENB), P4.11, U10.4 (A2)
/snd: P1.35 (SND), P4.9
/y_rc: U4.14 (O1), U9.6 (A4)
/y_rd: U4.12 (O3), U9.8 (A6)
/y_wc: U4.15 (O0), U9.5 (A3)
/y_wd: U4.13 (O2), U9.7 (A5)
GND: C1.2, C2.2, C3.2, C4.2, C5.2, C6.2, C7.2, C8.2, C9.2, C10.2, J3.4, P1.33 (GND), P1.34 (GND), TP1.1, TP3.1, TP4.1, U1.4 (E1), U1.8 (GND), U2.4 (E1), U2.8 (GND), U3.4 (E1), U3.5 (E2), U3.8 (GND), U4.8 (GND), U7.3 (GND), U7.8 (GND), U7.13 (GND), U7.18 (GND), U7.23 (GND), U7.28 (GND), U7.33 (AGND), U7.38 (GND), U8.11 (GND), U8.12 (GND), U8.13 (GND), U8.22 (*OE), U9.9 (A7), U9.10 (A8), U9.11 (GND), U9.12 (GND), U9.13 (GND), U9.22 (*OE), U10.2 (DIR), U10.11 (GND), U10.12 (GND), U10.13 (GND), U10.14 (B8), U10.15 (B7), U10.16 (B6), U10.17 (B5)

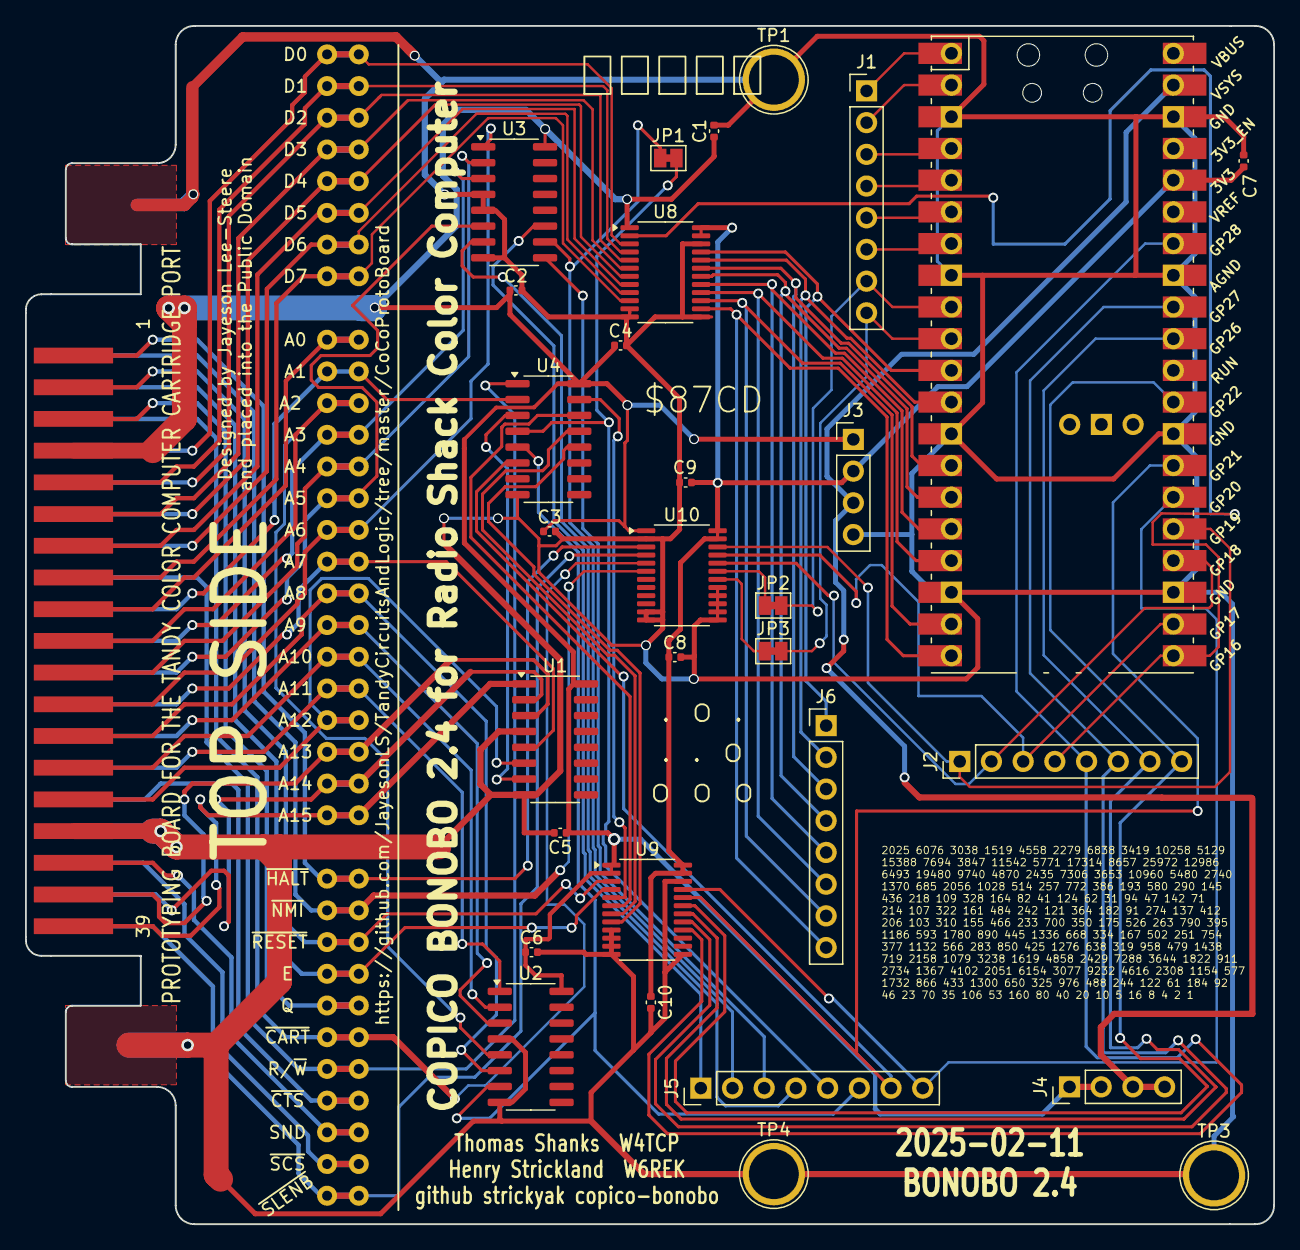
[picture p16: board spoon24b.kicad_pcb from above]

Board: 2 copper layers, 100.0 x 96.0 mm, 34 parts (0 on the bottom side), 78 nets.
