strickyak/copico-bonobo/(commit log)

2025-01-01 checkin v2.1 KICAD files.
    [spoon21g-bom.csv, spoon21g.kicad_pcb, spoon21g.kicad_sch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]
2025-01-07 add 2.2. Bugs: still says v2.1 on the board, in the long text.
    [spoon22k-bom.csv, spoon22k.kicad_pcb, spoon22k.kicad_sch, spoon22k.sch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]
2025-02-24 fixed NMI/Cart. Still flaky reset? run "sane" first.
    [bonobo-haltingly.py, bonobo-sane-null.py, bonobo-step52.py]
2025-02-24 kicad model v2.4/spoon24b.kicad_pro,...
    [spoon24b-bom.csv, spoon24b.kicad_pcb, spoon24b.kicad_sch, spoon24b.sch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]
2025-02-24 v2.4/spoon24b: Add PNGs of schematic & pcb
2025-03-21 ctrl & stat work for Probe, but HELLO Rx bad data.
2025-03-24 reply with 'b' for bonobo. DMA and faster.
2025-04-10 print arg number with fatal
2025-04-24 command 249: Start 2000 Hz Timer
2025-05-17 programmable timer
2025-08-13 add bonobo_ricku_*.stl files from Rick
    [bonobo_ricku_botM.stl, bonobo_ricku_topH.stl]
2026-02-09 Centipede experiments; currently without PIO.
2026-02-18 stability in watcher.cpp for centipede0
    [watcher.cpp]
2026-03-01 centipede-32d (made 20 samples)
    [centipede-32d.BOM.csv, centipede-32d.kicad_pcb, centipede-32d.kicad_sch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]
2026-03-02 failed attempt at irq: fire-on-rise-of-E
    [watcher-two.cpp]
2026-03-02 speedups and cleanups and GPIO direction flips
    [watcher-march.cpp, watcher-two.cpp]
2026-03-08 finally fixed, coco2 does 32kRAM & Floppy
    [watcher-march.cpp]
