strickyak/copico-bonobo/(notices)

Notices in the files:
v2.3/spoon23d/spoon23d.kicad_pcb:
and placed into the Public Domain
v3.1-centipede/centipede-32z/centipede-32z.kicad_pcb:
which is under the LGPL3.0 License.
Everything outside that 60-pin DIP is under the MIT License.
